alvaroferran/ZOOK/3D/Images/zookRender.jpg

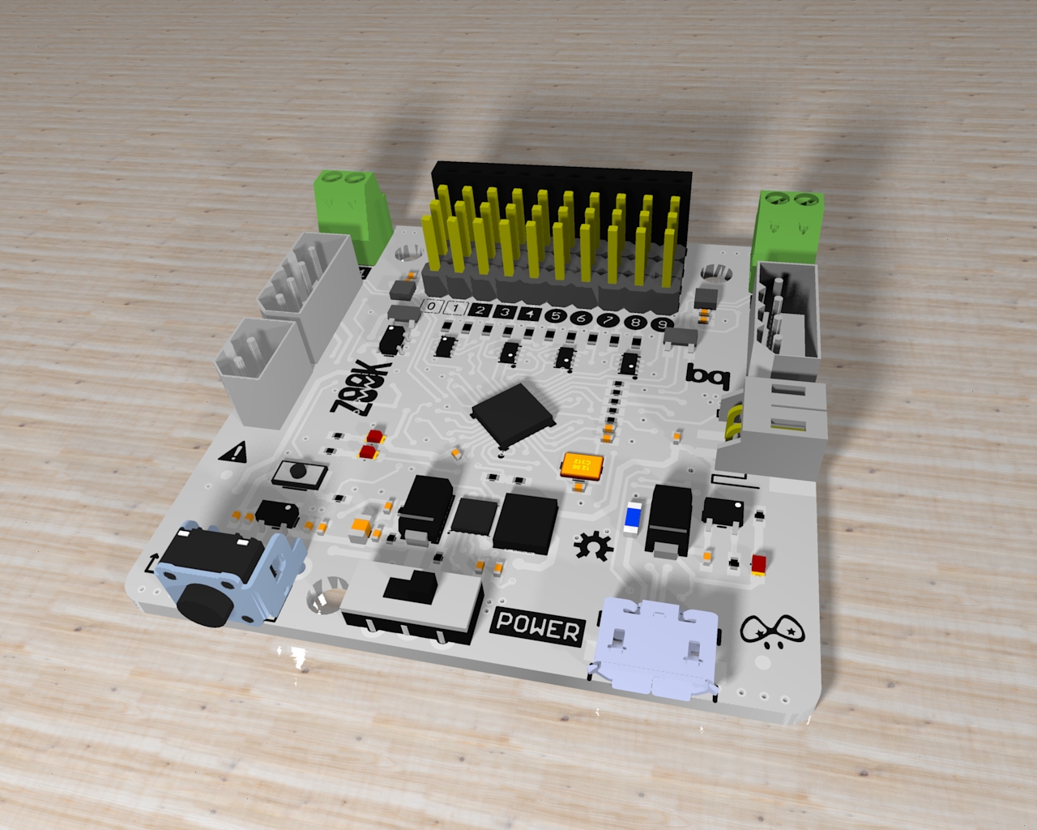
3D/Images/zookRender.jpg
