alvaroferran/ZOOK/Pres/zook_render.png

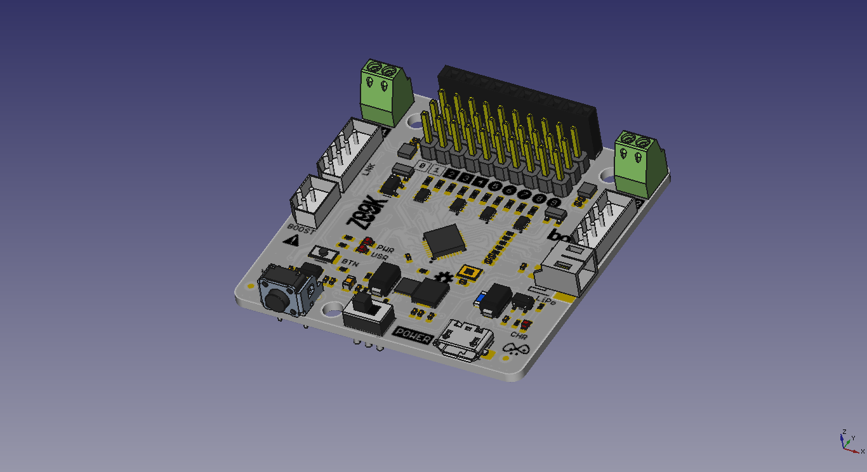
Pres/zook_render.png
