alvaroferran/ZOOK/3D/Images/zook1.png

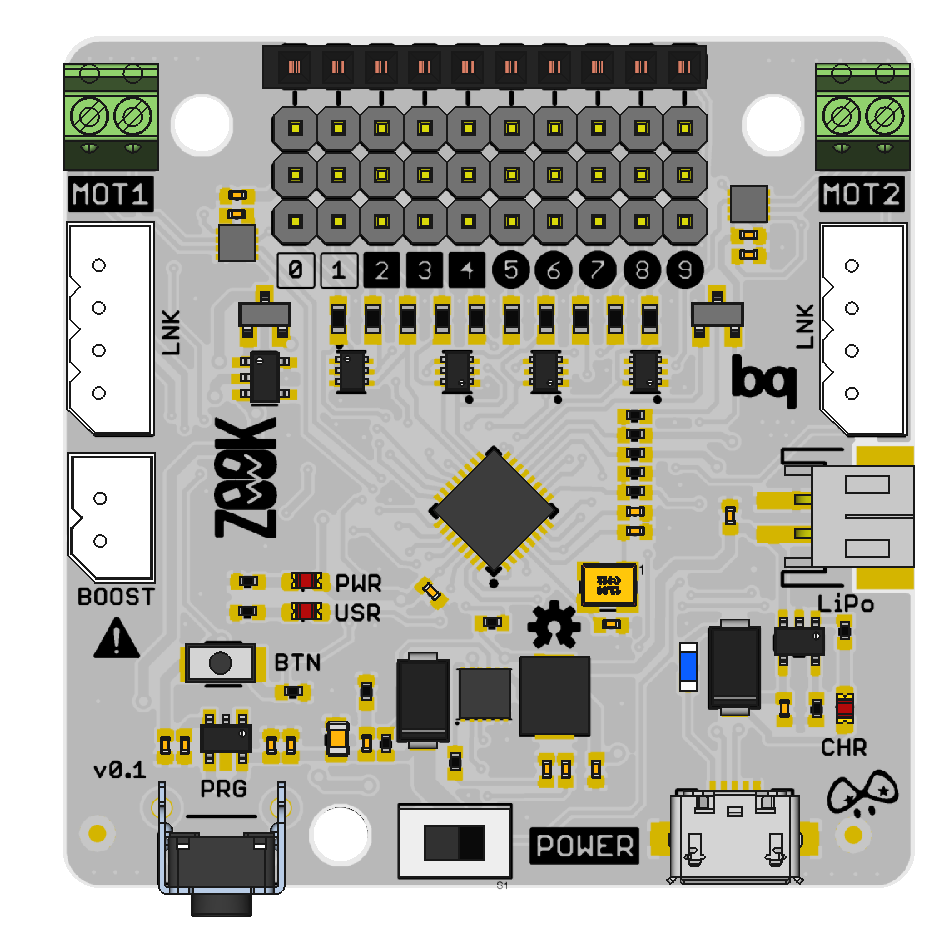
3D/Images/zook1.png
