alvaroferran/ZOOK/3D/Images/zook2.png

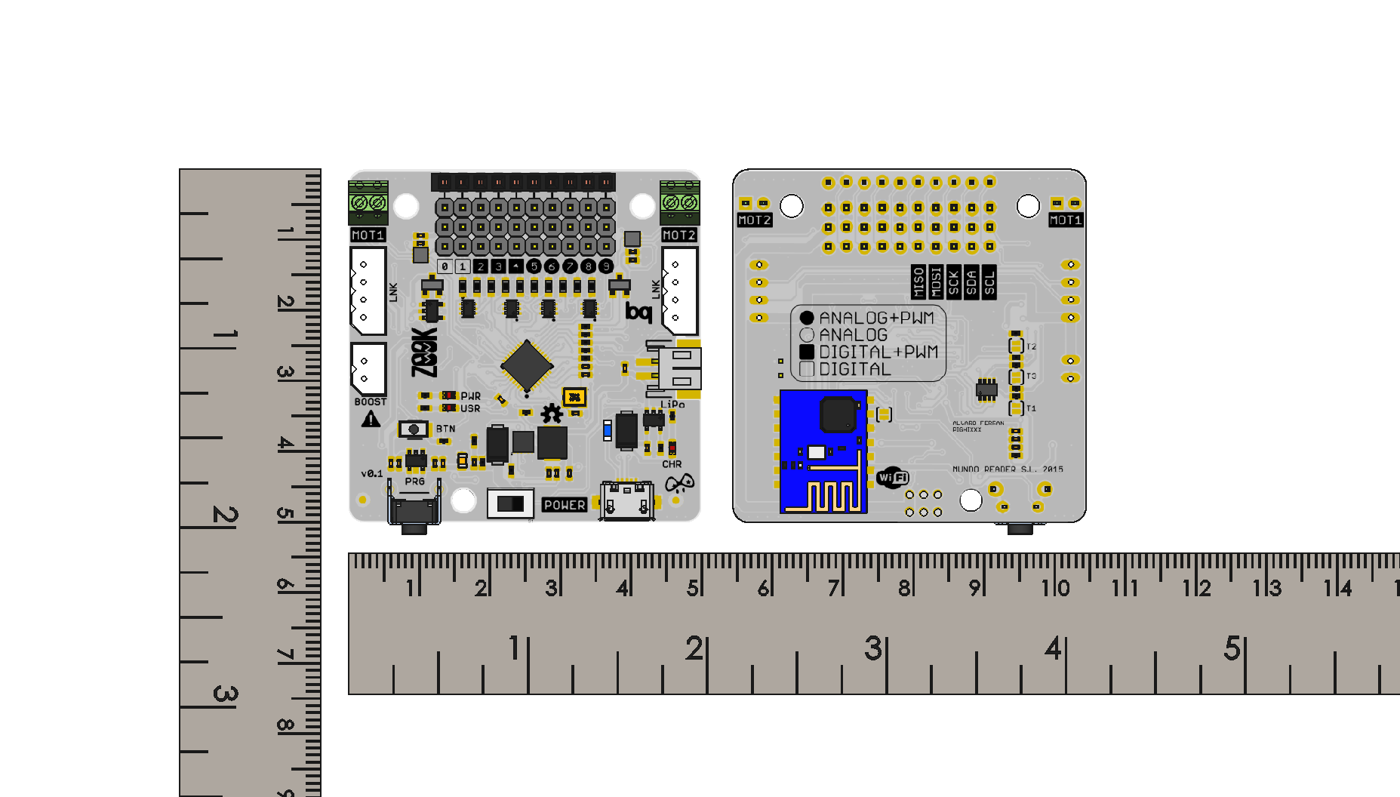
3D/Images/zook2.png
