alvaroferran/ZOOK/eagleUp/back.png

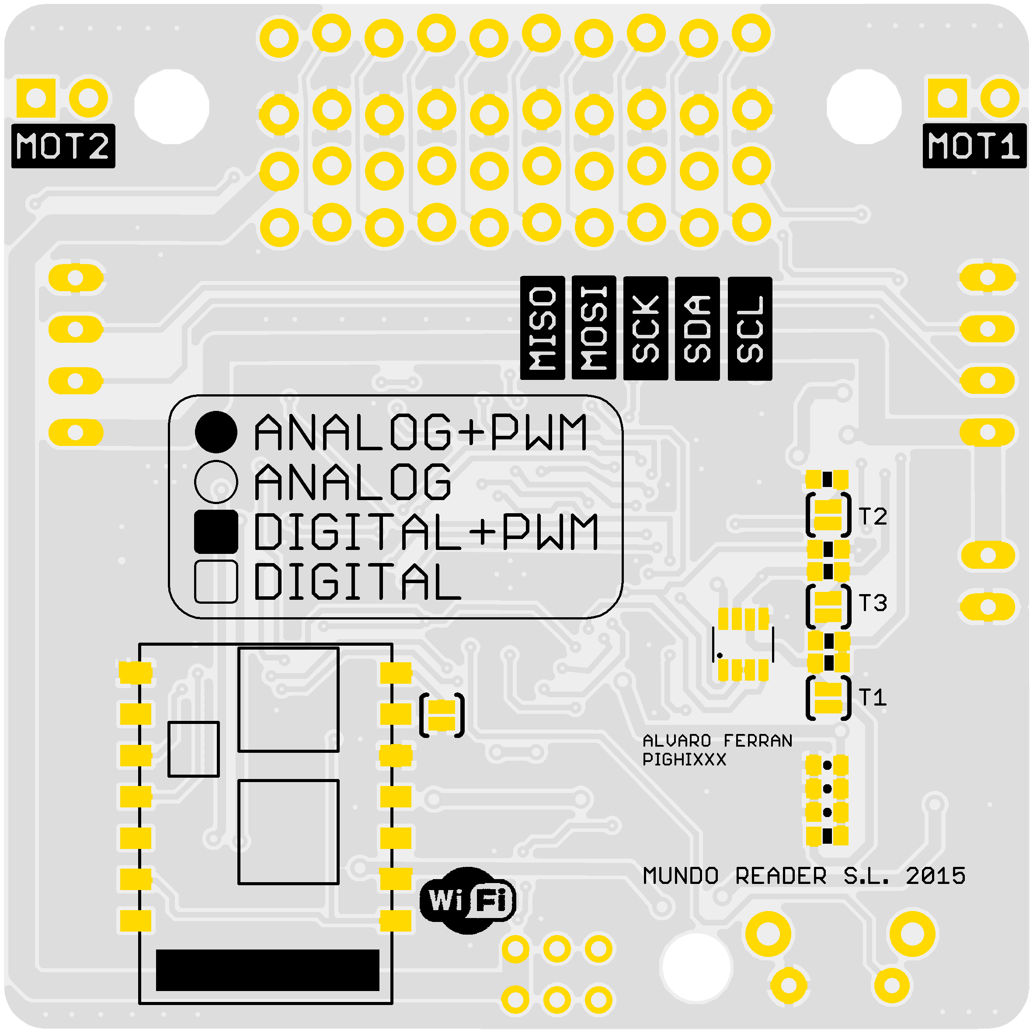
eagleUp/back.png
