alvaroferran/ZOOK/eagleUp/eagleUp_zook_board_top.png

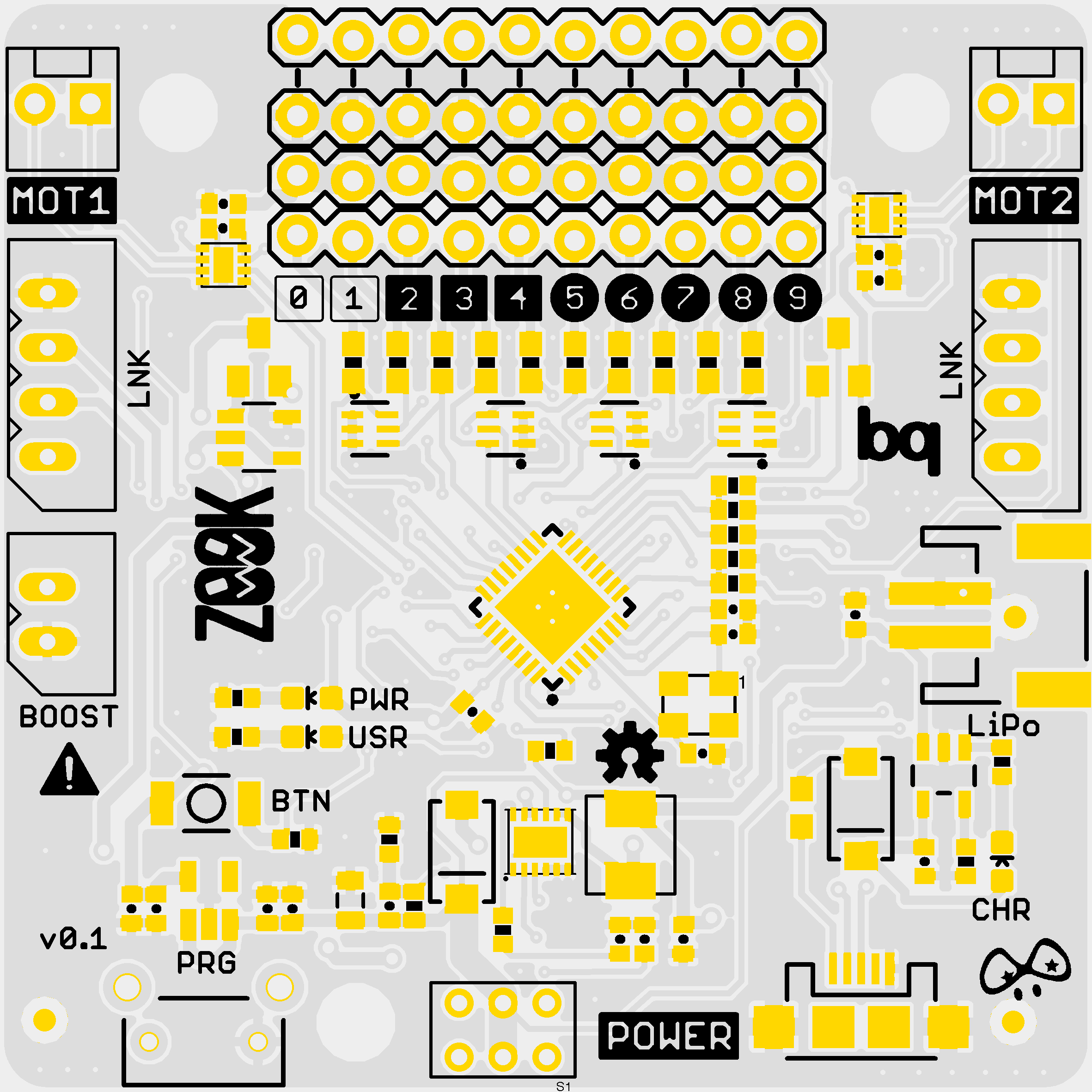
eagleUp/eagleUp_zook_board_top.png
