alvaroferran/ZOOK/eagleUp/eagleUp_zook_bottom.png

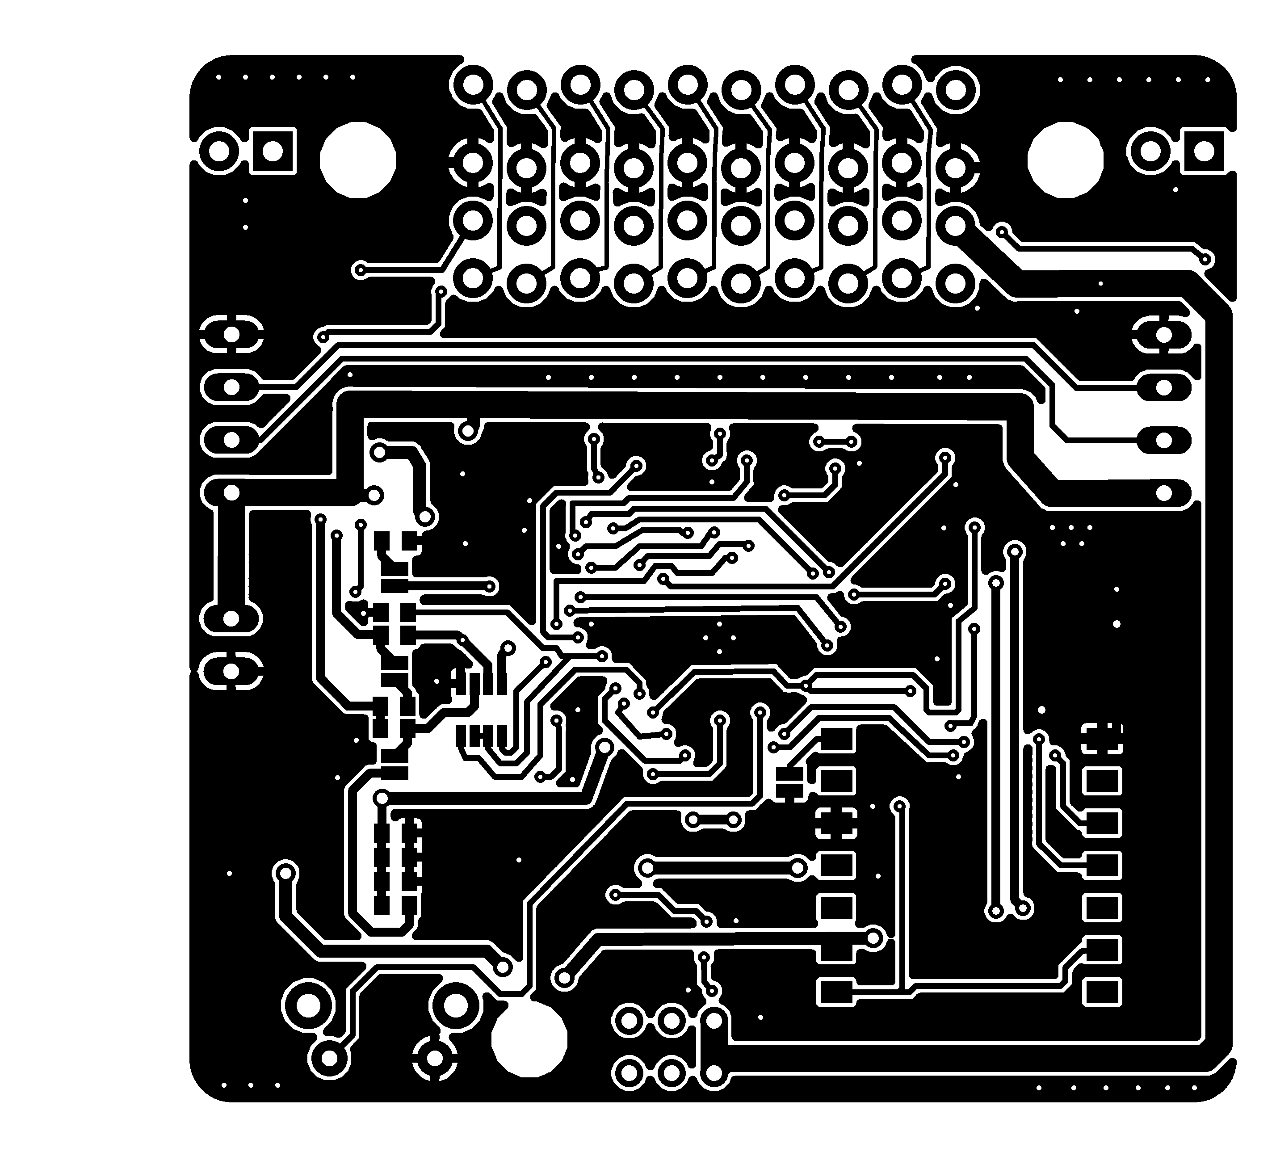
eagleUp/eagleUp_zook_bottom.png
