alvaroferran/ZOOK/eagleUp/eagleUp_zook_bottom_mask.png

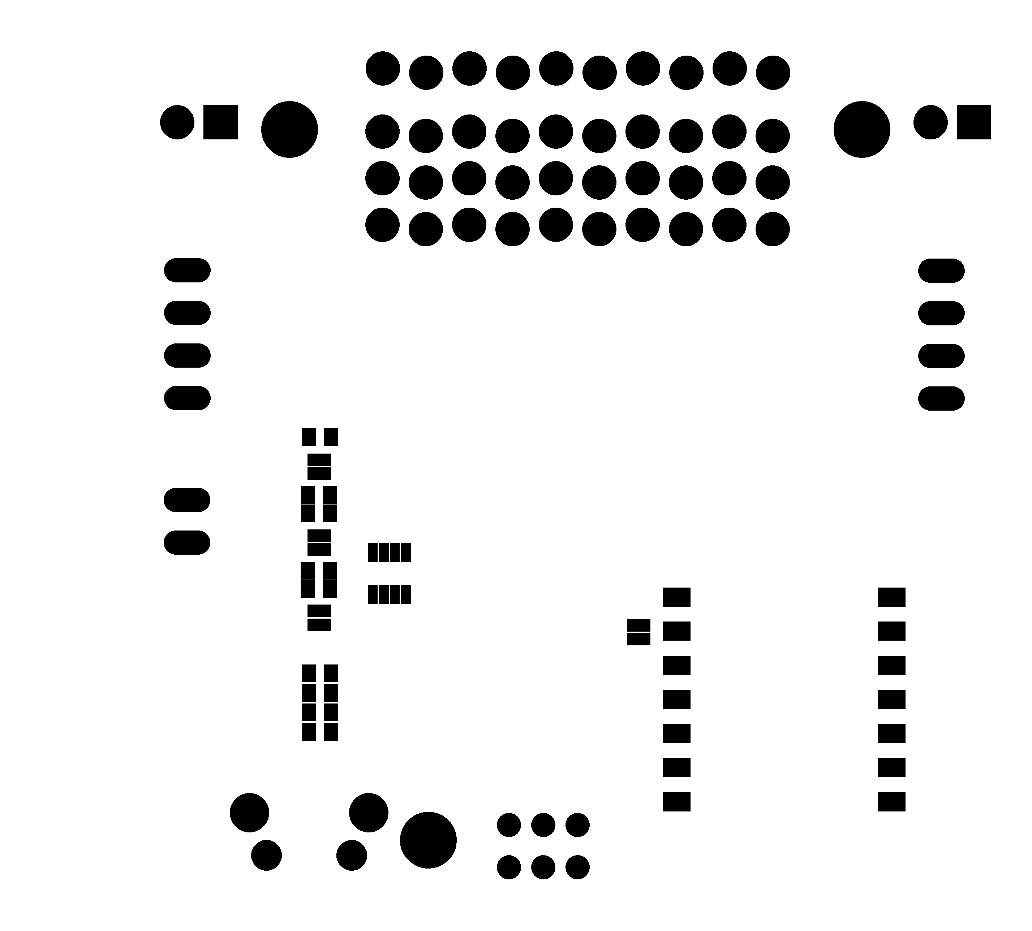
eagleUp/eagleUp_zook_bottom_mask.png
