alvaroferran/ZOOK/eagleUp/eagleUp_zook_bottom_silk.png

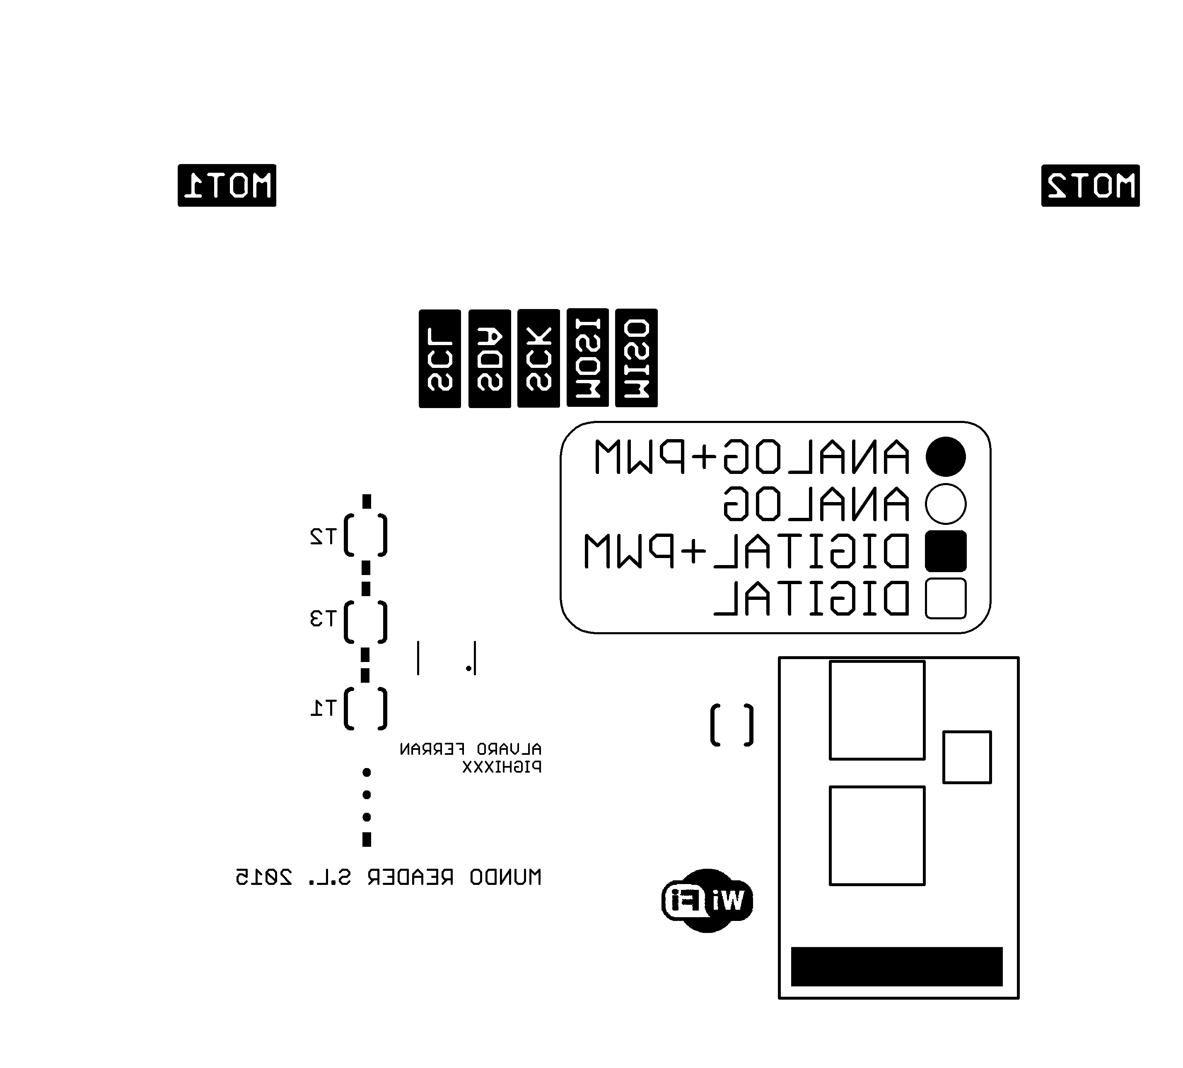
eagleUp/eagleUp_zook_bottom_silk.png
