alvaroferran/ZOOK/eagleUp/eagleUp_zook_imagesize.png

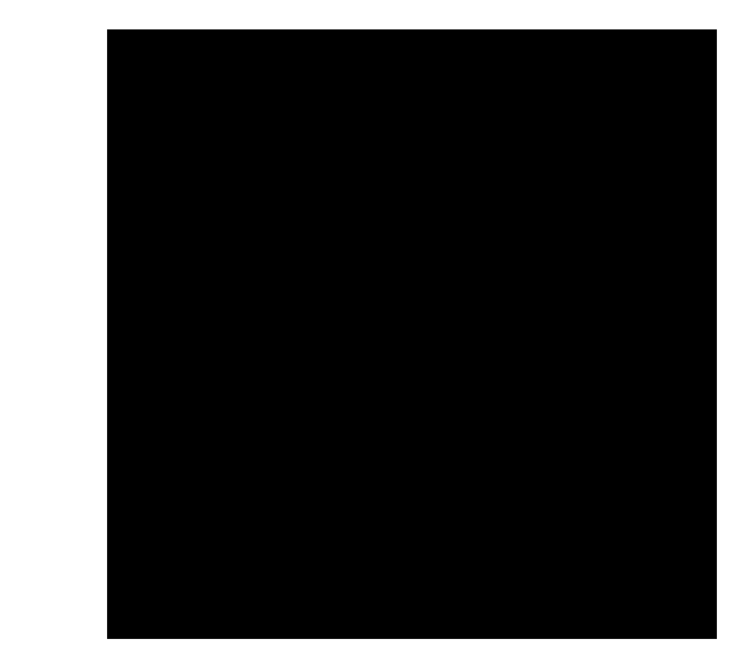
eagleUp/eagleUp_zook_imagesize.png
