alvaroferran/ZOOK/eagleUp/eagleUp_zook_outline.png

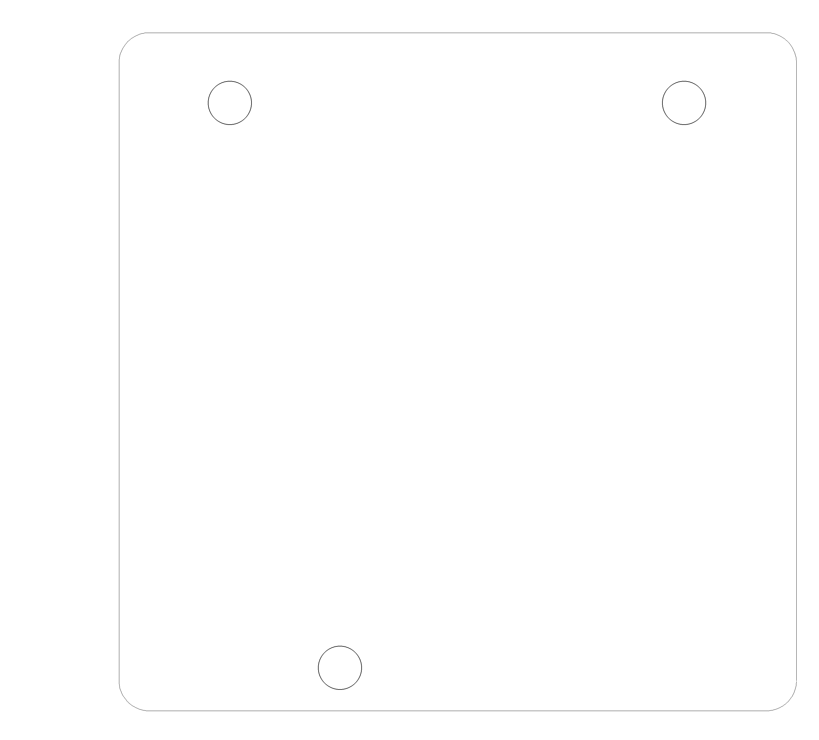
eagleUp/eagleUp_zook_outline.png
