alvaroferran/ZOOK/eagleUp/eagleUp_zook_top.png

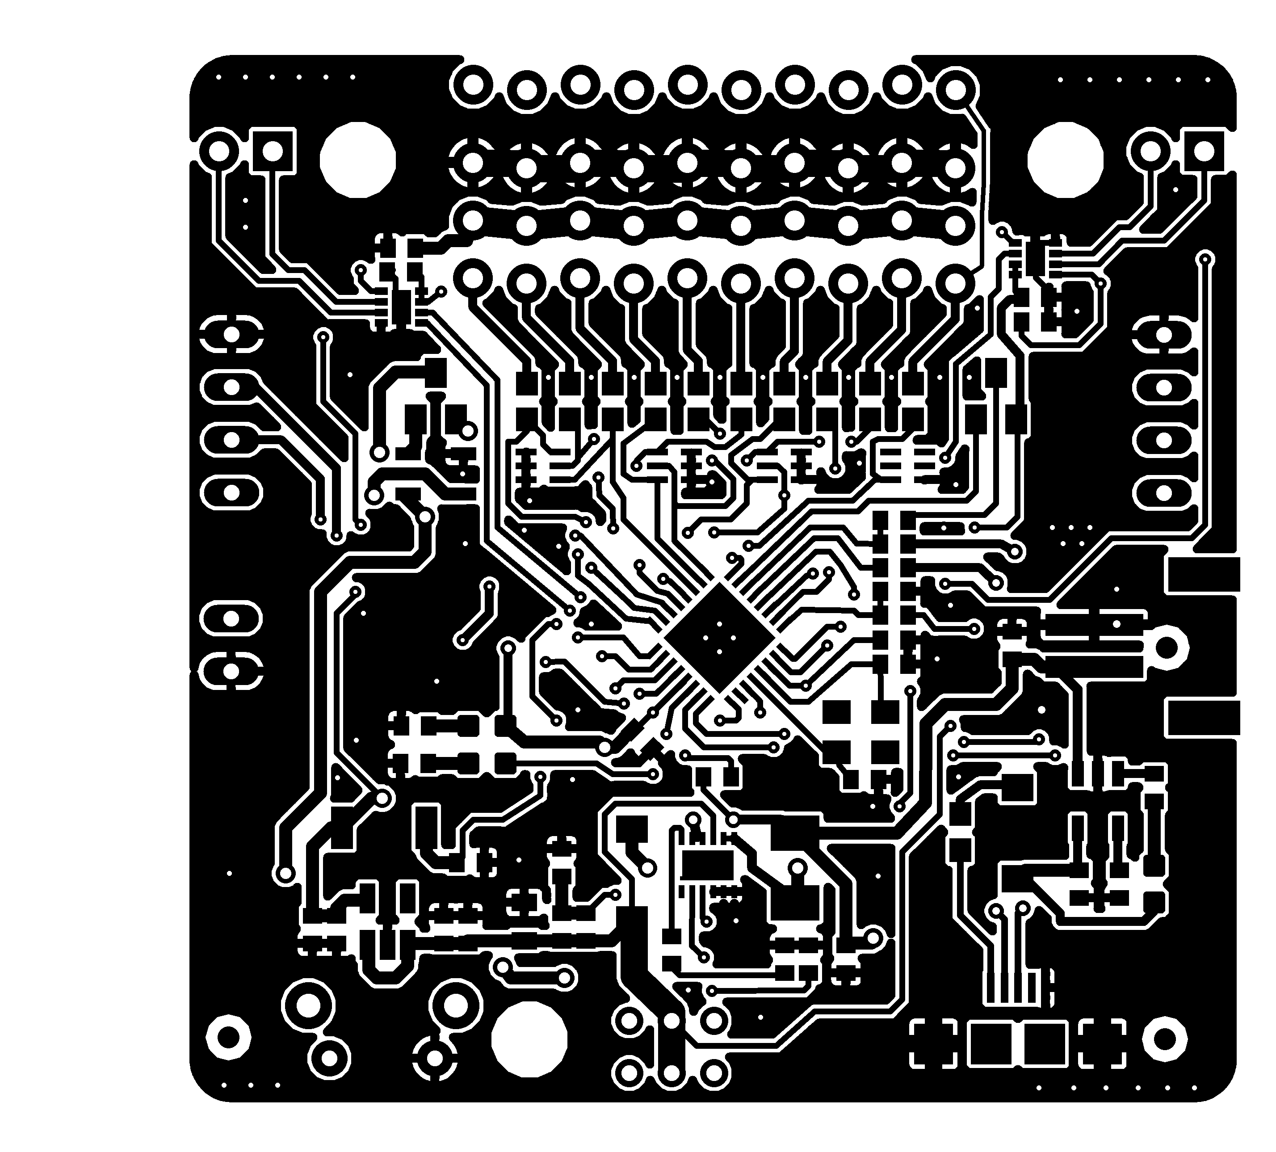
eagleUp/eagleUp_zook_top.png
