alvaroferran/ZOOK/eagleUp/eagleUp_zook_top_mask.png

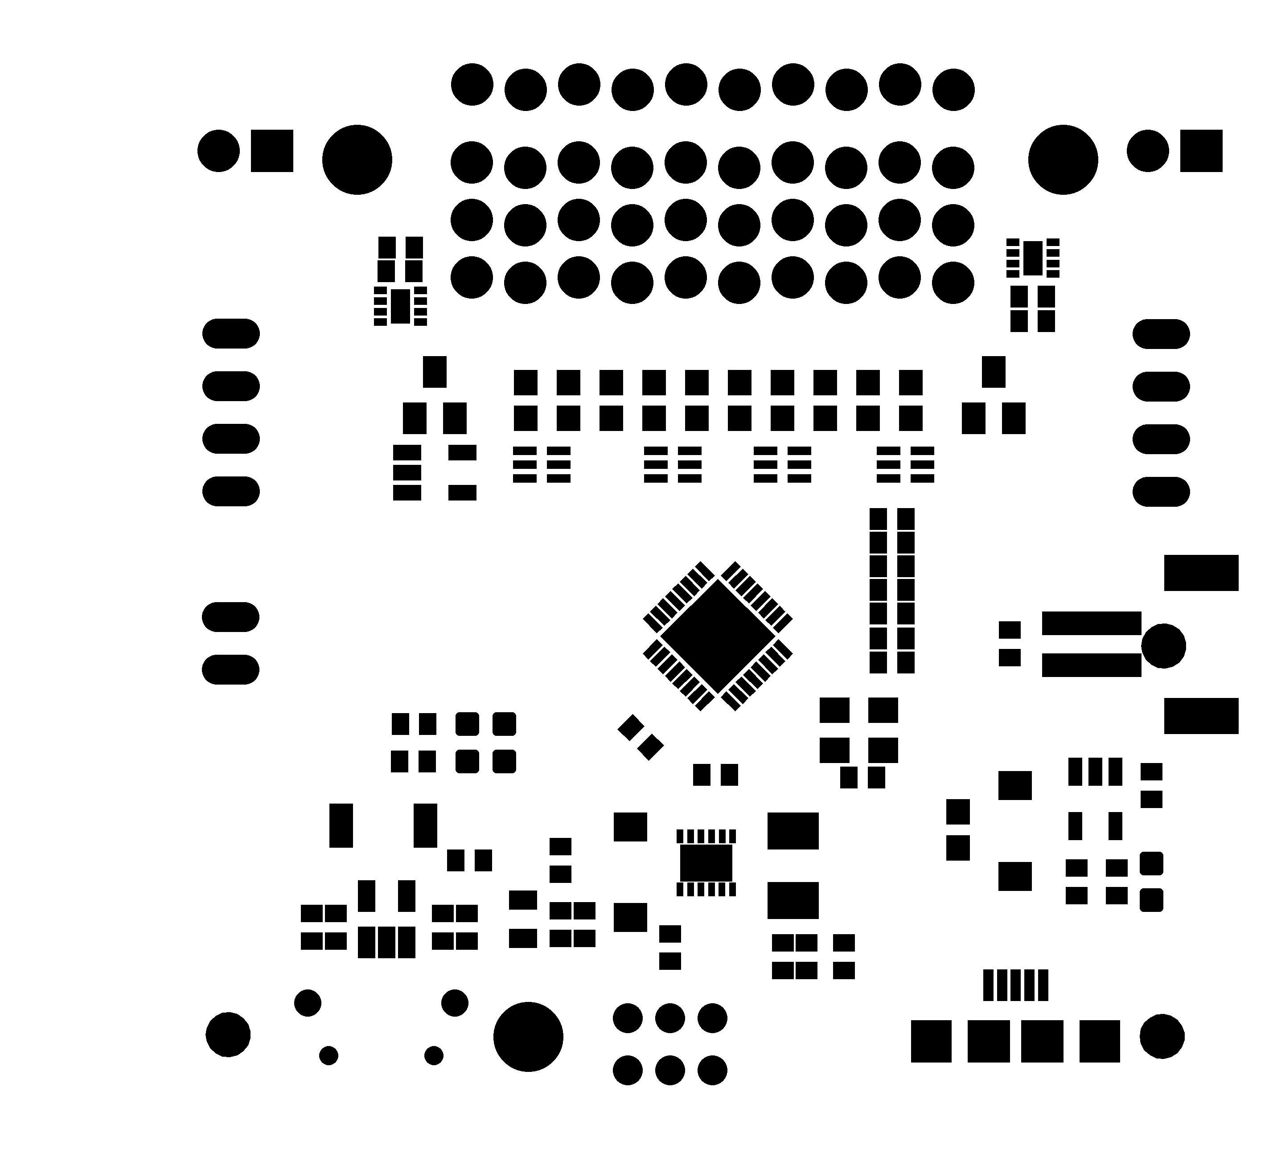
eagleUp/eagleUp_zook_top_mask.png
