alvaroferran/ZOOK/eagleUp/eagleUp_zook_top_silk.png

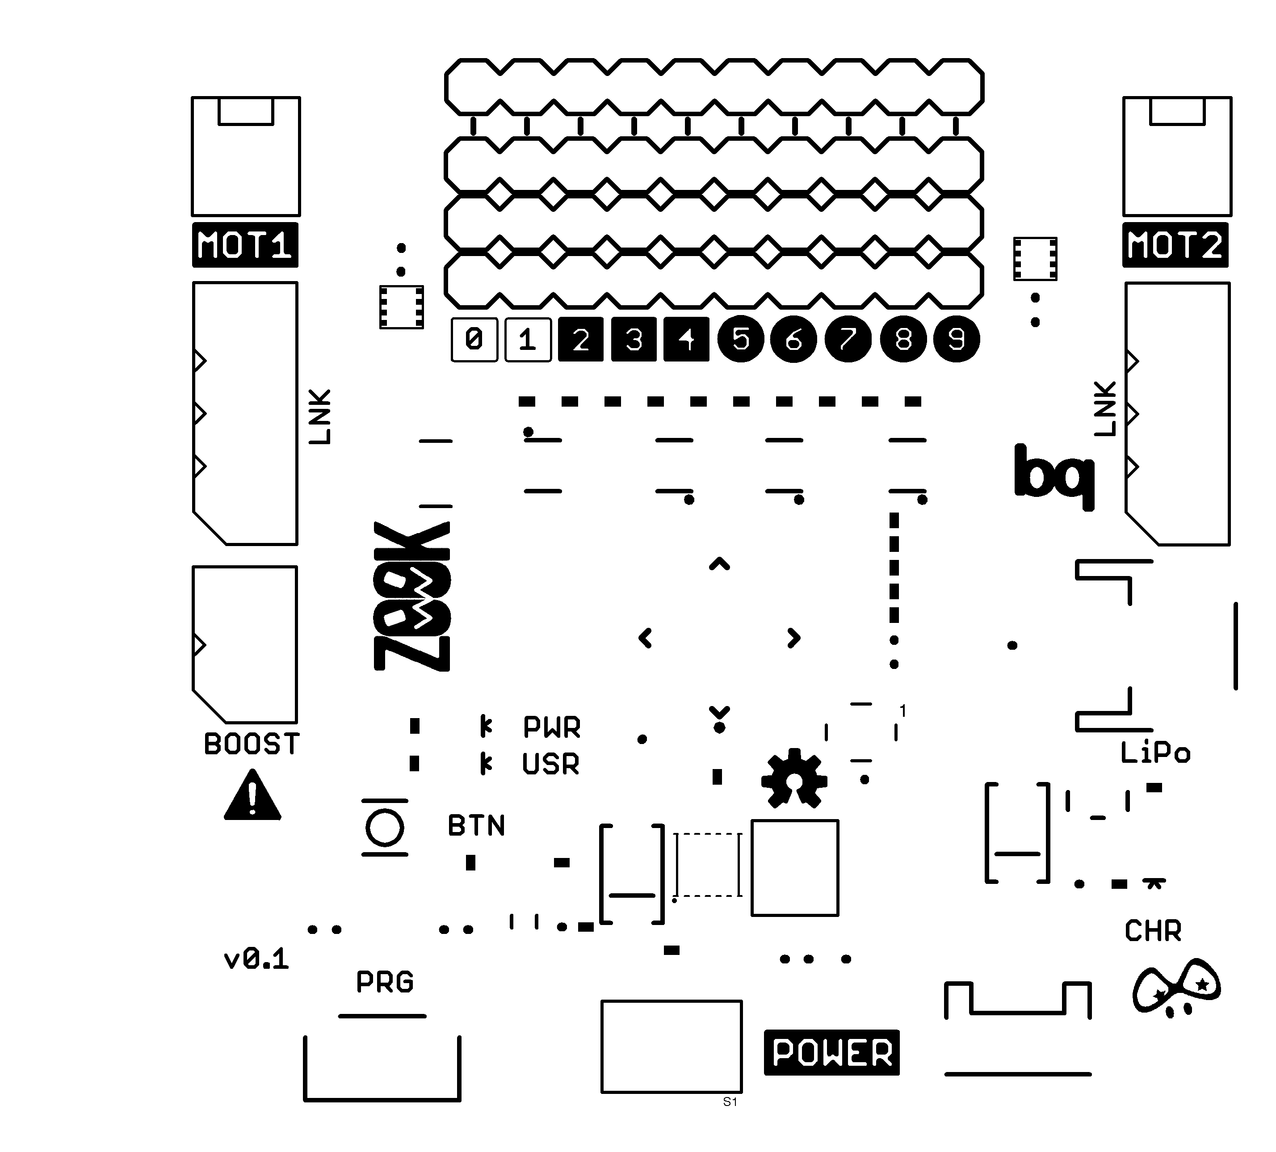
eagleUp/eagleUp_zook_top_silk.png
