alvaroferran/ZOOK/BOM/bom.ods

Part | Value | Device | Package | Description | Vendor | Code | Price | Notes
C1 | 0.1uF | CAP0402-CAP | 0402-CAP | Capacitor | TME | 0402YD104KAT2A | 0.00247
C2 | 0.1uF | CAP0402-CAP | 0402-CAP | Capacitor | TME | 0402YD104KAT2A | 0.00247
C3 | 2.2uF | CAP0402-CAP | 0402-CAP | Capacitor | TME | CL05A225KP5NSNC | 0.03218
C4 | 4.7uF | CAP0402-CAP | 0402-CAP | Capacitor | TME | AMK105BJ475MV | 0.1014
C5 | 10nF | CAP0402-CAP | 0402-CAP | Capacitor | TME | 0402YC103KAT2A | 0.0022
C6 | 100pF | CAP0402-CAP | 0402-CAP | Capacitor | TME | CL05C101JB5NNNC | 0.002
C7 | 22uF | CAP0805-CAP | 0805-CAP | Capacitor | TME | CL21A226MQQNNNG | 0.01476
C8 | 0.1uF | CAP0402-CAP | 0402-CAP | Capacitor | TME | 0402YD104KAT2A | 0.00247
C9 | 1uF | CAP0402-CAP | 0402-CAP | Capacitor | TME | CL05A105KQ5NNNC | 0.00297
C10 | 10uF 10V | CAP0402-CAP | 0402-CAP | Capacitor | TME | CL05A106MQ5NUNC | 0.0297
C11 | 10uF 10V | CAP0402-CAP | 0402-CAP | Capacitor | TME | CL05A106MQ5NUNC | 0.0297
C12 | 4.7uF | CAP0402-CAP | 0402-CAP | Capacitor | TME | AMK105BJ475MV | 0.1014
C13 | 10uF 10V | CAP0402-CAP | 0402-CAP | Capacitor | TME | CL05A106MQ5NUNC | 0.0297
C14 | 0.1uF | CAP0402-CAP | 0402-CAP | Capacitor | TME | 0402YD104KAT2A | 0.00247
C15 | 1uF | CAP0402-CAP | 0402-CAP | Capacitor | TME | CL05A105KQ5NNNC | 0.00297
C16 | 0.1uF | CAP0402-CAP | 0402-CAP | Capacitor | TME | 0402YD104KAT2A | 0.00247
C17 | 27pF | CAP0402-CAP | 0402-CAP | Capacitor | TME | CL05C270JB5NNNC | 0.00249
C18 | 27pF | CAP0402-CAP | 0402-CAP | Capacitor | TME | CL05C270JB5NNNC | 0.00249
C19 | 0.1uF | CAP0402-CAP | 0402-CAP | Capacitor | TME | 0402YD104KAT2A | 0.00247
C20 | 0.1uF | CAP0402-CAP | 0402-CAP | Capacitor | TME | 0402YD104KAT2A | 0.00247
C21 | 0.1uF | CAP0402-CAP | 0402-CAP | Capacitor | TME | 0402YD104KAT2A | 0.00247
C22 | 0.1uF | CAP0402-CAP | 0402-CAP | Capacitor | TME | 0402YD104KAT2A | 0.00247
D1 | MBRA140 | MBRA140 | SMA-DIODE | 40V, 1A Schottky rectifier | DIGIKEY | MBRA140T3GOSCT-ND | 0,098827
D2 | ZENERARRAY | ZENERARRAY | SOT363 |  | DIGIKEY | BZX84C5V1TS-FDICT-ND | 0,098827
D3 | ZENERARRAY | ZENERARRAY | SOT363 |  | DIGIKEY | BZX84C5V1TS-FDICT-ND | 0,098827
D4 | ZENERARRAY | ZENERARRAY | SOT363 |  | DIGIKEY | BZX84C5V1TS-FDICT-ND | 0,098827
D5 | ZENERARRAY | ZENERARRAY | SOT363 |  | DIGIKEY | BZX84C5V1TS-FDICT-ND | 0,098827
D6 | B340A | DIODE-SCHOTTKY-B340A | SMA-DIODE | Schottky diodes in SFEs production catalog | TME | B340A-13-F | 0.1182
F1 | PTC0603 | PTC0603 | 603 | Resettable Fuse PTC | AE |  | 0.2
IC1 | LMC7101AIM5 | LMC7101AIM5 | SOT23-5 |  | TME | LMC7101AIM5NOPB | 0.47
J1 | 5267-4 | 5267-4 | 5267-4 |  | TME | MX-5267-04A | 0.0524
J2 | 5267-4 | 5267-4 | 5267-4 |  | TME | MX-5267-04A | 0.0524
J3 | BATT | JST_2MM_MALE | JST-2-SMD | Mates to single-cell LiPo batteries. | DIGIKEY | 455-1704-ND | 0,066266
J5 | 5267-2 | 5267-2 | 5267-2 |  | TME | MX-5267-02A | 0.0302
JP1 | M10LOCK | M10LOCK | 1X10_LOCK | Header 10 | TME | ZL201-10G | 0.04504
JP2 | USB-MICROB | USB-MICROB | USB-MICROB | USB Connectors | ED |  | 0.11
JP3 | M10LOCK | M10LOCK | 1X10_LOCK | Header 10 | TME | ZL201-10G | 0.04504
JP4 | M10LOCK | M10LOCK | 1X10_LOCK | Header 10 | TME | ZL201-10G | 0.04504
JP5 | MOT1 | M02POLAR | MOLEX-1X2 | Standard 2-pin 0.1" header. Use with | TME | 282834-2 | 0.39
JP6 | MOT2 | M02POLAR | MOLEX-1X2 | Standard 2-pin 0.1" header. Use with | TME | 282834-2 | 0.39
L1 | MPI4040R3-2R2-R | MPI4040R3-2R2-R | MPI4040R3-2R2-R |  | Farnell | 2145278 | 0.536
LED1 |  | LED0603 | LED-0603 | LEDs | TME | OSR50603C1C | 0.0201
LED2 |  | LED0603 | LED-0603 | LEDs | TME | OSR50603C1C | 0.0201
LED3 |  | LED0603 | LED-0603 | LEDs | TME | OSR50603C1C | 0.0201
Q1 | 12MHz 4 pad crystal 3.2x2.5 | CRYSTAL3.2X2.5 | CRYSTAL_3.2X2.5 |  | Vertical | ABM8-12.000MHZ-B2-T | 0.28
Q2 | BSS84 | BSS84 | SOT23 | P-CHANNEL MOS FET | TME | BSS84.215 | 0.0289
Q3 | IRLML9301TR | BSS84 | SOT23 | P-CHANNEL MOS FET | TME | IRLML9301TRPBF | 0.0651
R1 | 100k | RESISTOR0402-RES | 0402-RES | Resistor | TME | SMD0402-100K | 0.00237
R2 | 220 | RESISTOR0603-RES | 0603-RES | Resistor | TME | SMD0603-220R-1% | 0.0022
R3 | 220 | RESISTOR0603-RES | 0603-RES | Resistor | TME | SMD0603-220R-1% | 0.0022
R4 | 220 | RESISTOR0603-RES | 0603-RES | Resistor | TME | SMD0603-220R-1% | 0.0022
R5 | 220 | RESISTOR0603-RES | 0603-RES | Resistor | TME | SMD0603-220R-1% | 0.0022
R6 | 220 | RESISTOR0603-RES | 0603-RES | Resistor | TME | SMD0603-220R-1% | 0.0022
R7 | 220 | RESISTOR0603-RES | 0603-RES | Resistor | TME | SMD0603-220R-1% | 0.0022
R8 | 220 | RESISTOR0603-RES | 0603-RES | Resistor | TME | SMD0603-220R-1% | 0.0022
R9 | 220 | RESISTOR0603-RES | 0603-RES | Resistor | TME | SMD0603-220R-1% | 0.0022
R10 | 220 | RESISTOR0603-RES | 0603-RES | Resistor | TME | SMD0603-220R-1% | 0.0022
R11 | 220 | RESISTOR0603-RES | 0603-RES | Resistor | TME | SMD0603-220R-1% | 0.0022
R12 | 620 | RESISTOR0402-RES | 0402-RES | Resistor | TME | SMD0402-620R-1% | 0.00237
R13 | 4.7k | RESISTOR0402-RES | 0402-RES | Resistor | TME | SMD0402-4K7-1% | 0.00237
R14 | 4.7k | RESISTOR0402-RES | 0402-RES | Resistor | TME | SMD0402-4K7-1% | 0.00237
R15 | 30.9k | RESISTOR0402-RES | 0402-RES | Resistor | DIGIKEY | 541-30.9KLCT-ND | 0,016693
R16 | 56 | RESISTOR0402-RES | 0402-RES | Resistor | TME | SMD0402-56R-1% | 0.00237
R17 | 56 | RESISTOR0402-RES | 0402-RES | Resistor | TME | SMD0402-56R-1% | 0.00237
R18 | 10k | RESISTOR0402-RES | 0402-RES | Resistor | TME | RC0402FR-0710K | 0.002
R19 | 330 | RESISTOR0402-RES | 0402-RES | Resistor | TME | SMD0402-330R-1% | 0.00237
R20 | 120 | RESISTOR0402-RES | 0402-RES | Resistor | TME | SMD0402-120R-1% | 0.00237
R21 | 330 | RESISTOR0402-RES | 0402-RES | Resistor | TME | SMD0402-330R-1% | 0.00237
R22 | 10k | RESISTOR0402-RES | 0402-RES | Resistor | TME | RC0402FR-0710K | 0.002
R23 | 330 | RESISTOR0402-RES | 0402-RES | Resistor | TME | SMD0402-330R-1% | 0.00237
R24 | 2K | RESISTOR0402-RES | 0402-RES | Resistor | TME | SMD0402-2K-1% | 0.00237
R25 | 1k | RESISTOR0402-RES | 0402-RES | Resistor | TME | SMD0402-1K-1% | 0.00237
R26 | 100k | RESISTOR0402-RES | 0402-RES | Resistor | TME | SMD0402-100K | 0.00237
R27 | 1.5K | RESISTOR0402-RES | 0402-RES | Resistor | TME | SMD0402-1K5-1% | 0.00237
R28 | 33 | RESISTOR0402-RES | 0402-RES | Resistor | TME | SMD0402-33R-1% | 0.00237
R29 | 33 | RESISTOR0402-RES | 0402-RES | Resistor | TME | SMD0402-33R-1% | 0.00237
R30 | 0 | RESISTOR0402-RES | 0402-RES | Resistor | TME | SMD0402-0R | 0.00237
S1 |  | SWITCH-MOMENTARY-2SMD-3 | TACTILE_SWITCH_SMD-3 | Various NO switches- pushbuttons, reed, etc | ED | EVP-AKB11A | 0.04
S2 |  | SWITCH-SPDTPTH | SWITCH-SPDT | SPDT Switch | ED | 563-1387-ND | 0.06 | 563-1385-ND | 1.62885
S3 | PROGR | SWITCH-MOMENTARY-2SIDE_EZ | TACTILE-PTH-SIDEEZ | Various NO switches- pushbuttons, reed, etc | DIGIKEY | 450-1662-ND | 0,091151
U1 |  | MIC2253 | MLF12_3.0MM_X_3.0MM | MIC2253 – 3.5ABoost Regulator | DIGIKEY | 576-3643-1-ND | 0,957827
U2 | ESP8266 | ESP8266 | ESP-03 | low cost Wifi to Serial Module | ED |  | 1
U3 | MCP73831 | MCP73831 | SOT23-5 | Miniature single cell Li-polymer charge controller | TME | MCP73831T-2AT | 0.45
U4 | DRV8837 | DRV8837 | DSG |  | DIGIKEY | 296-34786-2-ND | 0.506
U5 | DRV8837 | DRV8837 | DSG |  | DIGIKEY | 296-34786-2-ND | 0.506
U6 | AP2112K-3.3TRG1 3.3V | 5PIN_REG | SOT23-5 |  | DIGIKEY | AP2112K-3.3TRG1DICT-ND | 0,11076
U8 | LPC11U24 | LPC11U2X_HVQFN33(5X5) | HVQFN33_5X5MM |  | NEWARK | 74T4533 | 1.4
U9 | MAX3362 | MAX3362 | SOT23-8 | MAX3362 3.3VRS-485/RS-422 Transceiver | MAXIM | MAX3362AKA (https://shop.maximintegrated.com/storefront/quotecart.do;jsessionid=0181a53e4de57686ba28963c263dcfc0181b3e8e9cc94afbef82d4042b7d6509.e38Mbx8MbNuPaO0PahiMb3eOb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) | 1.5
 |  |  |  |  |  |  | 10.539832
