alvaroferran/ZOOK/BOM/bom.numbers/preview-web.jpg

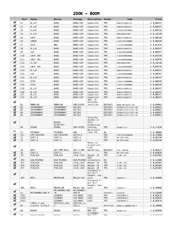
BOM/bom.numbers/preview-web.jpg
