alvaroferran/ZOOK/Outline/Outline.dxf

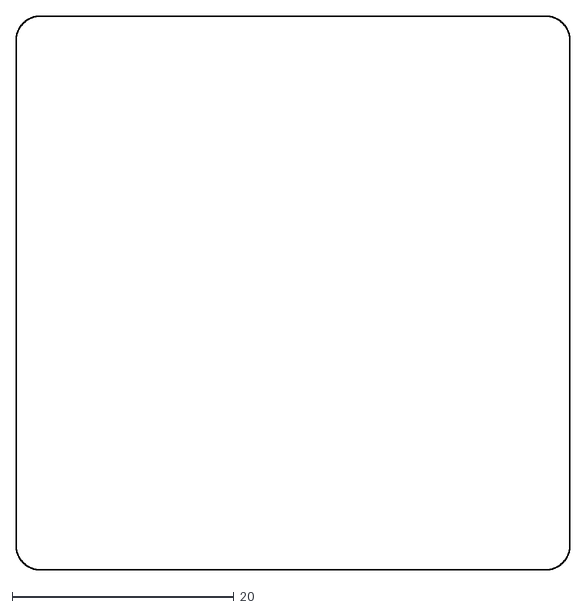
[picture p17: CAD file, 2015-11-03]
Outline/Outline.dxf
50.0 x 50.0
