alvaroferran/ZOOK/Pres/zook_freecad.fcstd

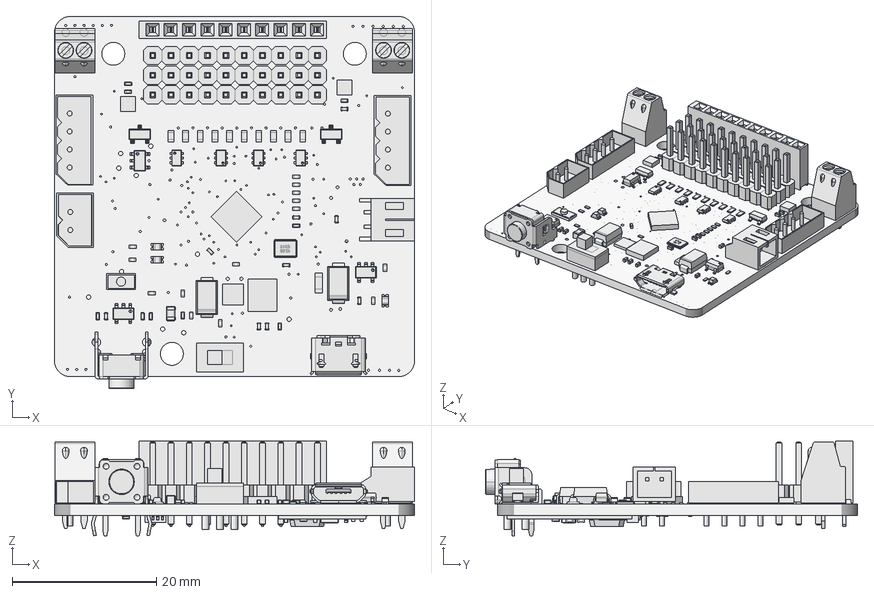
[picture p18: CAD file, 2015-11-03]
Pres/zook_freecad.fcstd
50.0 x 51.6 x 13.1 mm
Board
Q3
Q1
R18
R12
R15
R24
R19
R13
R14
R16
R17
R20
R1
R25
R26
R29
R28
R27
R21
R23
R22
R30
C4
C12
C9
C15
C3
C1
C6
C5
C11
C13
C19
C21
C20
C22
C2
C10
C8
C17
C18
C14
C16
U2
D6
D1
U5
IC1
U4
JP2
J4
C7
U6
U7
JP5
JP6
LED1
LED2
LED3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
