alvaroferran/ZOOK/Pres/zook_schematic.pdf

1

2

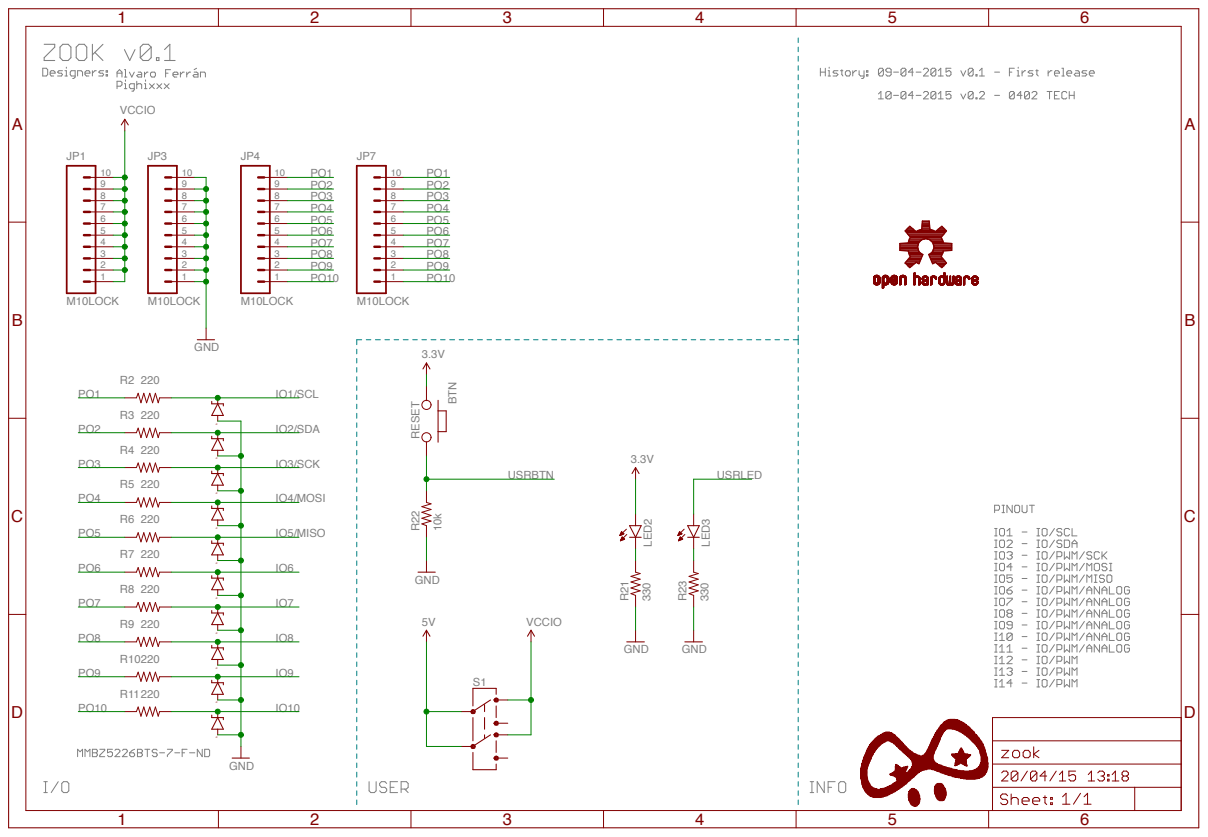
[picture p19: page 1]

1 | 2 | 3 | 4 | 5 | 6

A

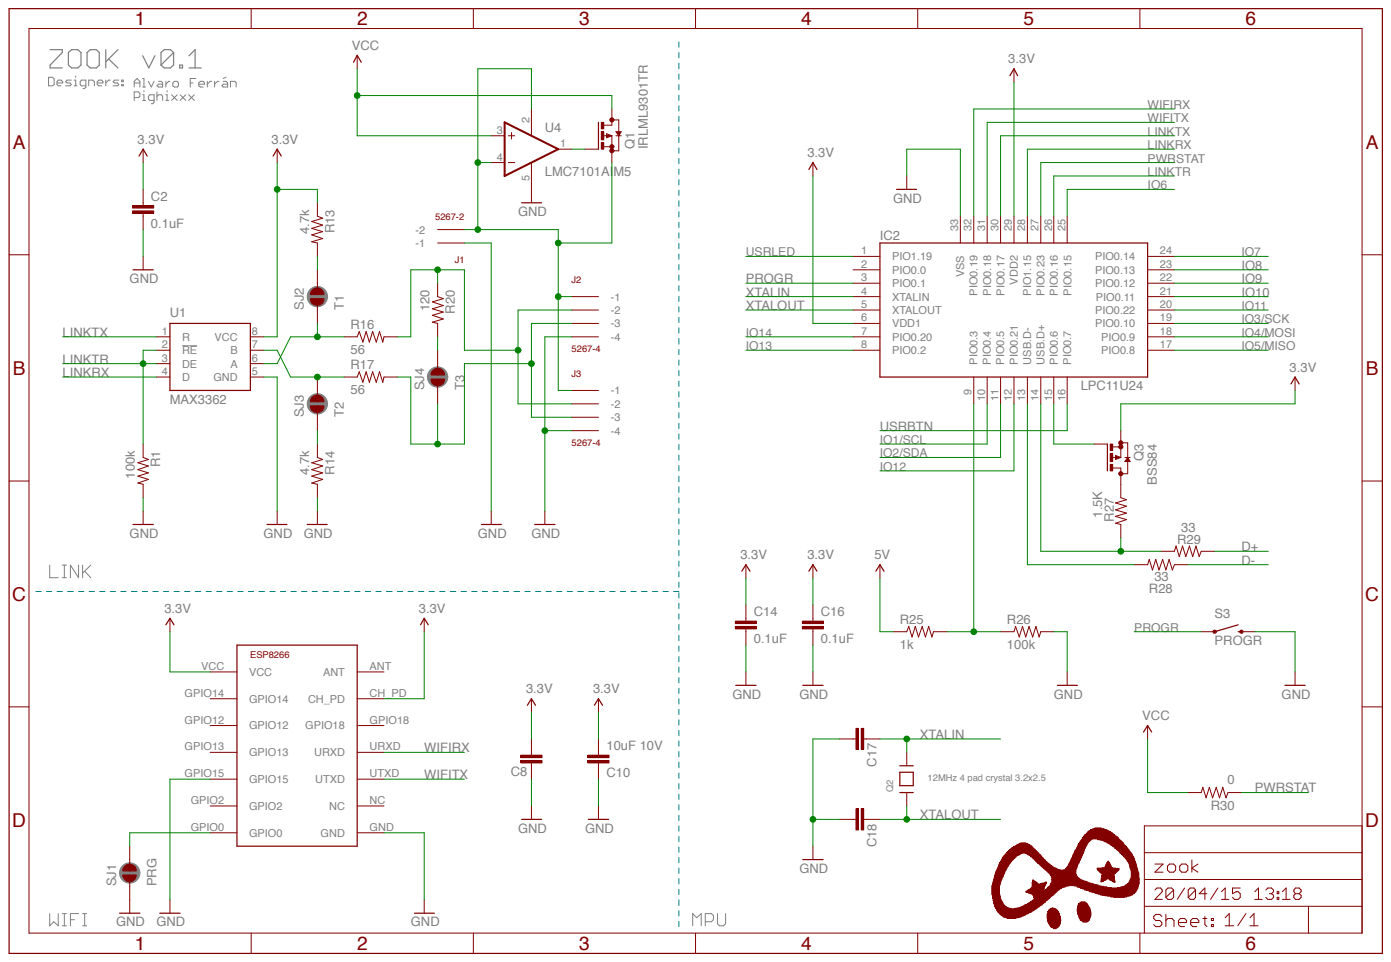
[picture p20: page 2]

VCC

A

A

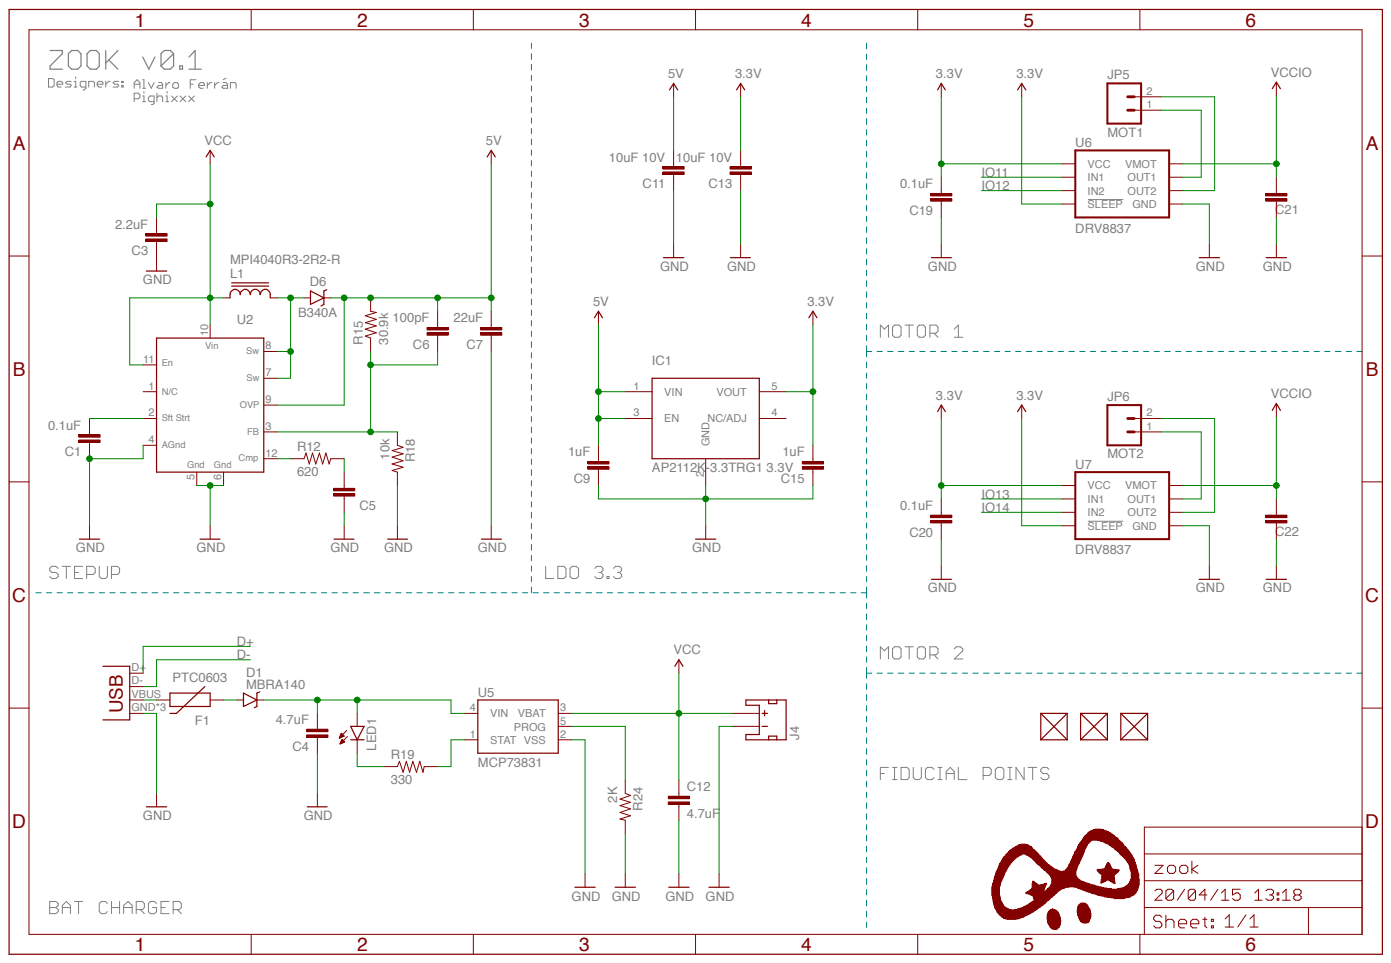
[picture p21: page 3]
