alvaroferran/ZOOK/zook.pdf

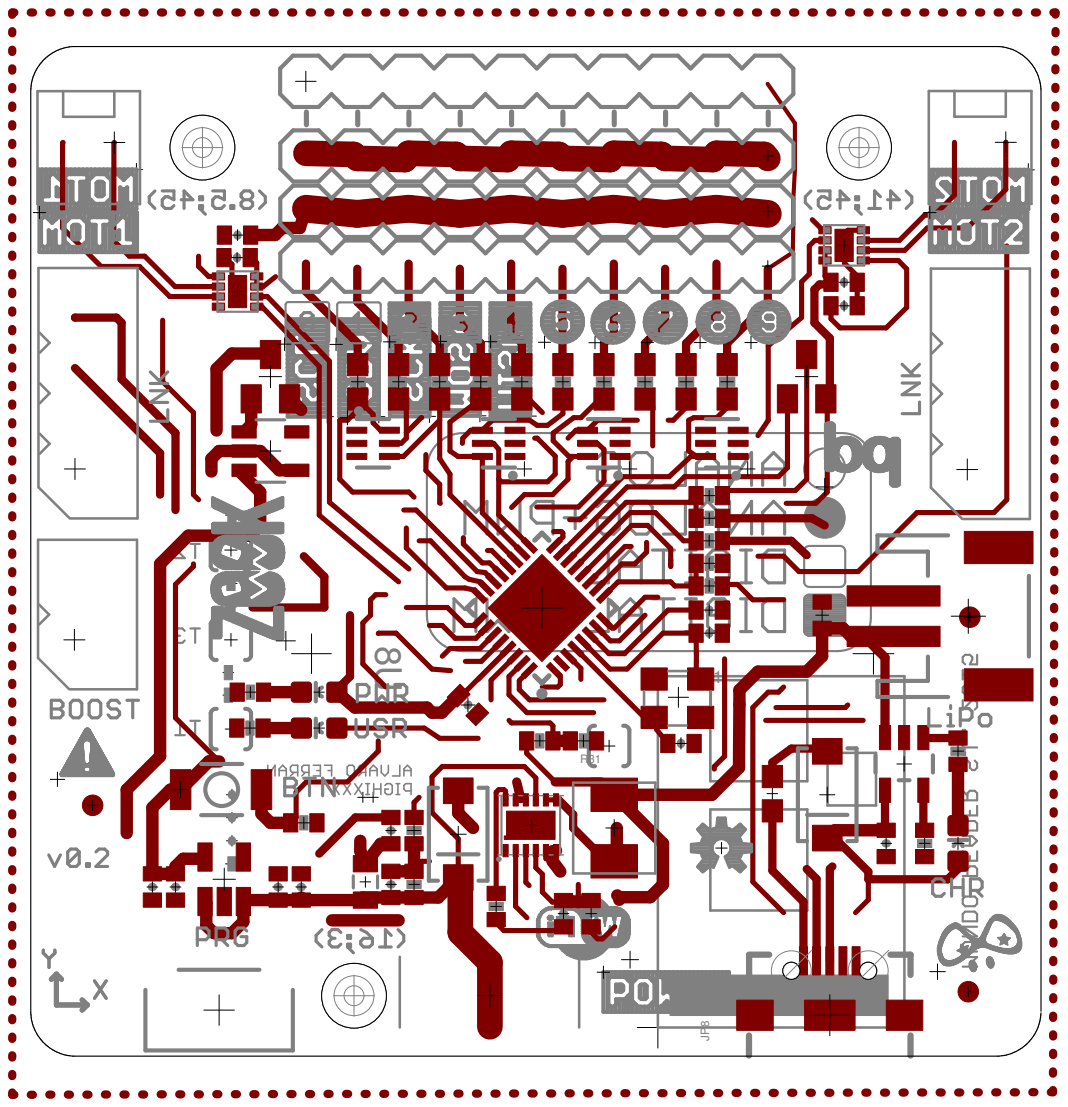
[picture p22: page 1]
