alvaroferran/ZOOK/zook.brd

## EAGLE design zook.brd (2015-11-03)

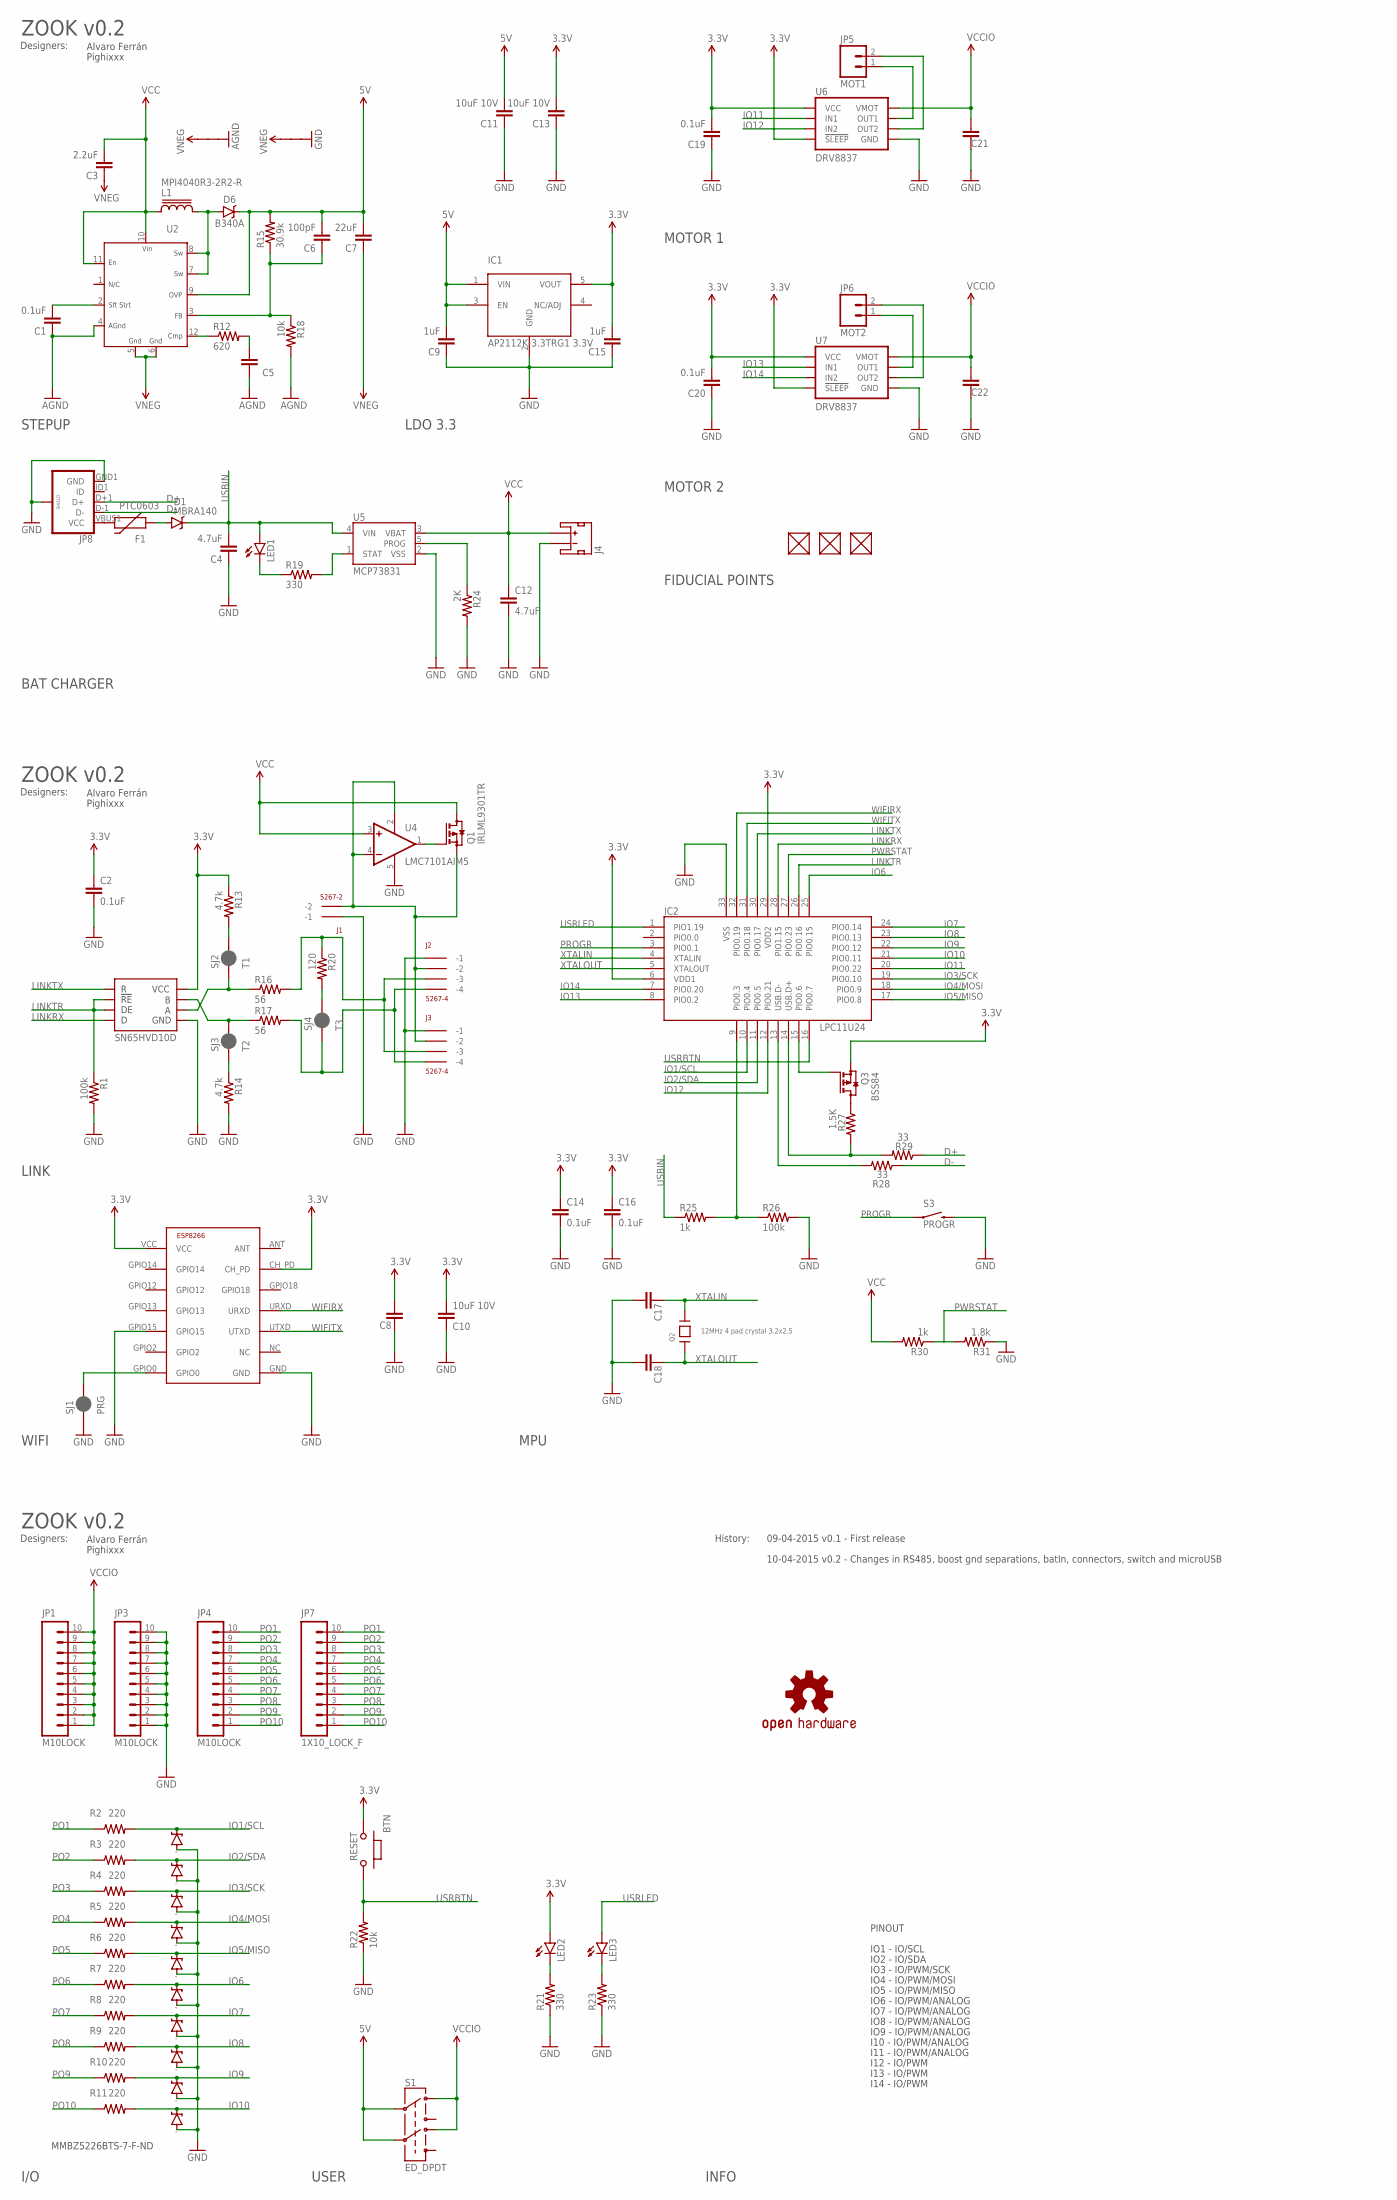
[picture p23: schematic zook.sch]

Parts:
BTN: RESET; 157SW
C1, C2, C8, C14, C16, C19, C20, C21, C22: 0.1uF; 0402-CAP
C3: 2.2uF; 0402-CAP
C4, C12: 4.7uF; 0402-CAP
C5: 10nF; 0402-CAP
C6: 100pF; 0402-CAP
C7: 22uF; 0805
C9, C15: 1uF; 0402-CAP
C10, C11, C13: 10uF 10V; 0402-CAP
C17, C18: 27pF; 0402-CAP
D1: MBRA140; SMA-DIODE
D2, D3, D4, D5: ZENERARRAY; SOT363
D6: B340A; SMA-DIODE
F1: PTC0603; 0603
FUD1, FUD2, FUD3: FIDUCIAL; FIDUCIAL_40MIL
GND5, GND6: VIRTUAL_GND; STARGND
IC1: AP2112K-3.3TRG1 3.3V; SOT23-5
IC2: LPC11U24; HVQFN33_5X5MM
J1: 5267-2
J2, J3: 5267-4
J4: BATT; JST-2-SMD
JP1, JP3, JP4: M10LOCK; 1X10_LOCK
JP5: MOT1; MOLEX-1X2
JP6: MOT2; MOLEX-1X2
JP7: 1X10_LOCK_F
JP8: USB_MICROB_PLUGCONN-11752; USB-B-MICRO-SMD_V03
L1: MPI4040R3-2R2-R
LED1, LED2, LED3: LED0603; LED-0603
LOGO3: OSHW-LOGOS; OSHW-LOGO-S
Q1: IRLML9301TR; SOT23
Q2: 12MHz 4 pad crystal 3.2x2.5; CRYSTAL_3.2X2.5
Q3: BSS84; SOT23
R1, R26: 100k; 0402-RES
R2, R3, R4, R5, R6, R7, R8, R9, R10, R11: 220; 0603-RES
R12: 620; 0402-RES
R13, R14: 4.7k; 0402-RES
R15: 30.9k; 0402-RES
R16, R17: 56; 0402-RES
R18, R22: 10k; 0402-RES
R19, R21, R23: 330; 0402-RES
R20: 120; 0402-RES
R24: 2K; 0402-RES
R25, R30: 1k; 0402-RES
R27: 1.5K; 0402-RES
R28, R29: 33; 0402-RES
R31: 1.8k; 0402-RES
S1: ED_DPDT
S3: PROGR; TACTILE-PTH-SIDEEZ
SJ1: PRG; PAD-JUMPER-2-NC_BY_PASTE_YES_SILK
SJ2: T1; PAD-JUMPER-2-NC_BY_PASTE_YES_SILK
SJ3: T2; PAD-JUMPER-2-NC_BY_PASTE_YES_SILK
SJ4: T3; PAD-JUMPER-2-NC_BY_PASTE_YES_SILK
U2: MIC2253; MLF12_3.0MM_X_3.0MM
U3: ESP8266; ESP-03
U4: LMC7101AIM5; SOT23-5
U5: MCP73831; SOT23-5
U6, U7: DRV8837; DSG
U8: SN65HVD10D; SO08

Connections:
3.3V: BTN.1, C2.1, C8.2, C10.2, C13.2, C14.1, C15.2, C16.1, C19.2, C20.2, IC1.5 (VOUT), IC2.6 (VDD1), IC2.29 (VDD2), LED2.A, Q3.2 (S), R13.1, U3.CH_PD, U3.VCC, U6.7 (!SLEEP), U6.8 (VCC), U7.7 (!SLEEP), U7.8 (VCC), U8.8
5V: C6.2, C7.2, C9.2, C11.2, D6.C, IC1.1 (VIN), IC1.3 (EN), R15.2, S1.2, S1.5, U2.9 (OVP)
AGND: C1.1, C5.1, GND5.P$2, R18.2, U2.4 (AGND)
D+: JP8.D+1 (D+), R29.1
D-: JP8.D-1 (D-), R28.1
GND: C2.2, C4.1, C8.1, C9.1, C10.1, C11.1, C12.2, C13.1, C14.2, C15.1, C16.2, C17.2, C18.2, C19.1, C20.1, C21.1, C22.1, D2.1 (A), D2.2 (A), D2.3 (A), D3.1 (A), D3.2 (A), D3.3 (A), D4.1 (A), D4.2 (A), D4.3 (A), D5.1 (A), GND6.P$2, IC1.2 (GND), IC2.33 (VSS), J1.P$1 (-1), J2.P$1 (-1), J3.P$1 (-1), J4.1 (-), JP3.1, JP3.2, JP3.3, JP3.4, JP3.5, JP3.6, JP3.7, JP3.8, JP3.9, JP3.10, JP8.GND1 (GND), JP8.SHIELD1 (SHIELD), JP8.SHIELD2 (SHIELD), JP8.SHIELD3 (SHIELD), R1.2, R14.2, R21.1, R22.1, R23.1, R24.2, R26.2, R31.1, S3.2, SJ1.1, U3.GND, U3.GPIO15, U4.5 (V-), U5.2 (VSS), U6.4 (GND), U6.PAD (GND), U7.4 (GND), U7.PAD (GND), U8.5
IO1/SCL: D2.6 (C), IC2.10 (PIO0.4), R2.2
IO2/SDA: D2.5 (C), IC2.11 (PIO0.5), R3.2
IO3/SCK: D2.4 (C), IC2.19 (PIO0.10), R4.2
IO4/MOSI: D3.6 (C), IC2.18 (PIO0.9), R5.2
IO5/MISO: D3.5 (C), IC2.17 (PIO0.8), R6.2
IO6: D3.4 (C), IC2.25 (PIO0.15), R7.2
IO7: D4.6 (C), IC2.24 (PIO0.14), R8.2
IO8: D4.5 (C), IC2.23 (PIO0.13), R9.2
IO9: D4.4 (C), IC2.22 (PIO0.12), R10.2
IO10: D5.6 (C), IC2.21 (PIO0.11), R11.2
IO11: IC2.20 (PIO0.22), U6.6 (IN1)
IO12: IC2.12 (PIO0.21), U6.5 (IN2)
IO13: IC2.8 (PIO0.2), U7.6 (IN1)
IO14: IC2.7 (PIO0.20), U7.5 (IN2)
LINKRX: IC2.28 (PIO1.15), U8.4
LINKTR: IC2.26 (PIO0.16), R1.1, U8.2, U8.3
LINKTX: IC2.30 (PIO0.17), U8.1
unnamed: J2.P$4 (-4), J3.P$4 (-4), R17.2, SJ4.1
unnamed: LED2.C, R21.2
unnamed: C5.2, R12.2
unnamed: D6.A, L1.P$2 (2), U2.7 (SW), U2.8 (SW)
unnamed: C1.2, U2.2 (SS)
unnamed: F1.2, JP8.VBUS1 (VCC)
unnamed: R12.1, U2.12 (CMP)
unnamed: D1.A, F1.1
unnamed: JP5.1, U6.2 (OUT1)
unnamed: JP5.2, U6.3 (OUT2)
unnamed: R19.2, U5.1 (STAT)
unnamed: LED1.C, R19.1
unnamed: JP6.1, U7.2 (OUT1)
unnamed: JP6.2, U7.3 (OUT2)
unnamed: R17.1, SJ3.2, U8.7
unnamed: R16.1, SJ2.1, U8.6
unnamed: R13.2, SJ2.2
unnamed: R20.2, SJ4.2
unnamed: R14.1, SJ3.1
unnamed: J2.P$3 (-3), J3.P$3 (-3), R16.2, R20.1
unnamed: LED3.C, R23.2
unnamed: C6.1, R15.1, R18.1, U2.3 (FB)
unnamed: Q1.1 (G), U4.1 (OUT)
unnamed: J1.P$2 (-2), J2.P$2 (-2), J3.P$2 (-2), Q1.2 (S), U4.2 (V+), U4.4 (-IN)
unnamed: IC2.14 (USB.D+), R27.2, R29.2
unnamed: SJ1.2, U3.GPIO0
unnamed: IC2.13 (USB.D-), R28.2
unnamed: Q3.3 (D), R27.1
unnamed: IC2.15 (PIO0.6), Q3.1 (G)
P0.3/ISP_COMMAND_USB_HIGH: IC2.9 (PIO0.3), R25.2, R26.1
PO1: JP4.10, JP7.10, R2.1
PO2: JP4.9, JP7.9, R3.1
PO3: JP4.8, JP7.8, R4.1
PO4: JP4.7, JP7.7, R5.1
PO5: JP4.6, JP7.6, R6.1
PO6: JP4.5, JP7.5, R7.1
PO7: JP4.4, JP7.4, R8.1
PO8: JP4.3, JP7.3, R9.1
PO9: JP4.2, JP7.2, R10.1
PO10: JP4.1, JP7.1, R11.1
PROG: R24.1, U5.5 (PROG)
PROGR: IC2.3 (PIO0.1), S3.1
PWRSTAT: IC2.27 (PIO0.23), R30.1, R31.2
USBIN: C4.2, D1.C, LED1.A, R25.1, U5.4 (VIN)
USRBTN: BTN.2, IC2.16 (PIO0.7), R22.2
USRLED: IC2.1 (PIO1.19), LED3.A
VCC: C3.2, C12.1, J4.2 (+), L1.P$1 (1), Q1.3 (D), R30.2, U2.10 (VIN), U2.11 (EN), U4.3 (+IN), U5.3 (VBAT)
VCCIO: C21.2, C22.2, JP1.1, JP1.2, JP1.3, JP1.4, JP1.5, JP1.6, JP1.7, JP1.8, JP1.9, JP1.10, S1.1, S1.4, U6.1 (VMOT), U7.1 (VMOT)
VNEG: C3.1, C7.1, GND5.P$1, GND6.P$1, U2.5 (GND), U2.6 (GND)
WIFIRX: IC2.32 (PIO0.19), U3.URXD
WIFITX: IC2.31 (PIO0.18), U3.UTXD
XTALIN: C17.1, IC2.4 (XTALIN), Q2.3
XTALOUT: C18.1, IC2.5 (XTALOUT), Q2.1

Notes on the sheet:
STEPUP
LDO 3.3
BAT CHARGER
MOTOR 1
MOTOR 2
FIDUCIAL POINTS
ZOOK v0.2
Designers:
Alvaro Ferrán
Pighixxx
LINK
WIFI
MPU
I/O
USER
INFO
History:
09-04-2015 v0.1 - First release
IO1 - IO/SCL
IO2 - IO/SDA
IO3 - IO/PWM/SCK
IO4 - IO/PWM/MOSI
IO5 - IO/PWM/MISO
IO6 - IO/PWM/ANALOG
IO7 - IO/PWM/ANALOG
IO8 - IO/PWM/ANALOG
IO9 - IO/PWM/ANALOG
I10 - IO/PWM/ANALOG
PINOUT
MMBZ5226BTS-7-F-ND
10-04-2015 v0.2 - Changes in RS485, boost gnd separations, batIn, connectors, switch and microUSB
I11 - IO/PWM/ANALOG
I12 - IO/PWM
I13 - IO/PWM
I14 - IO/PWM

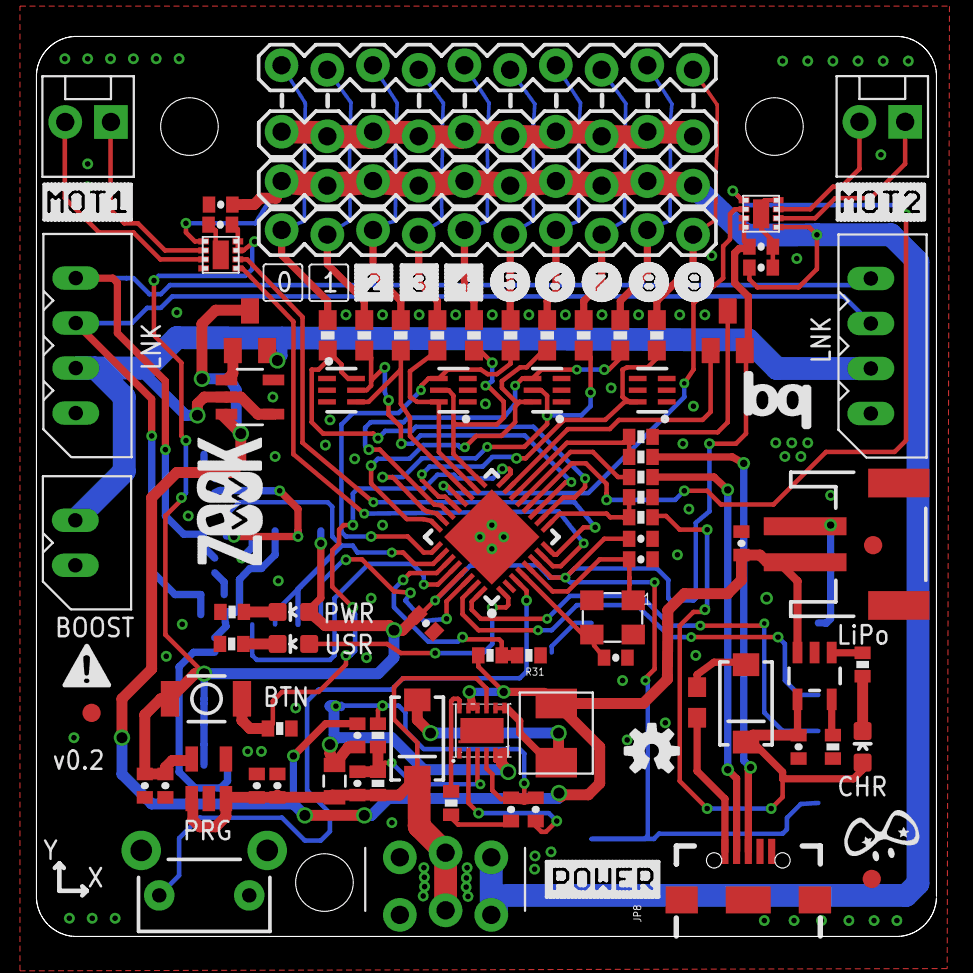
[picture p24: board zook.brd from above]

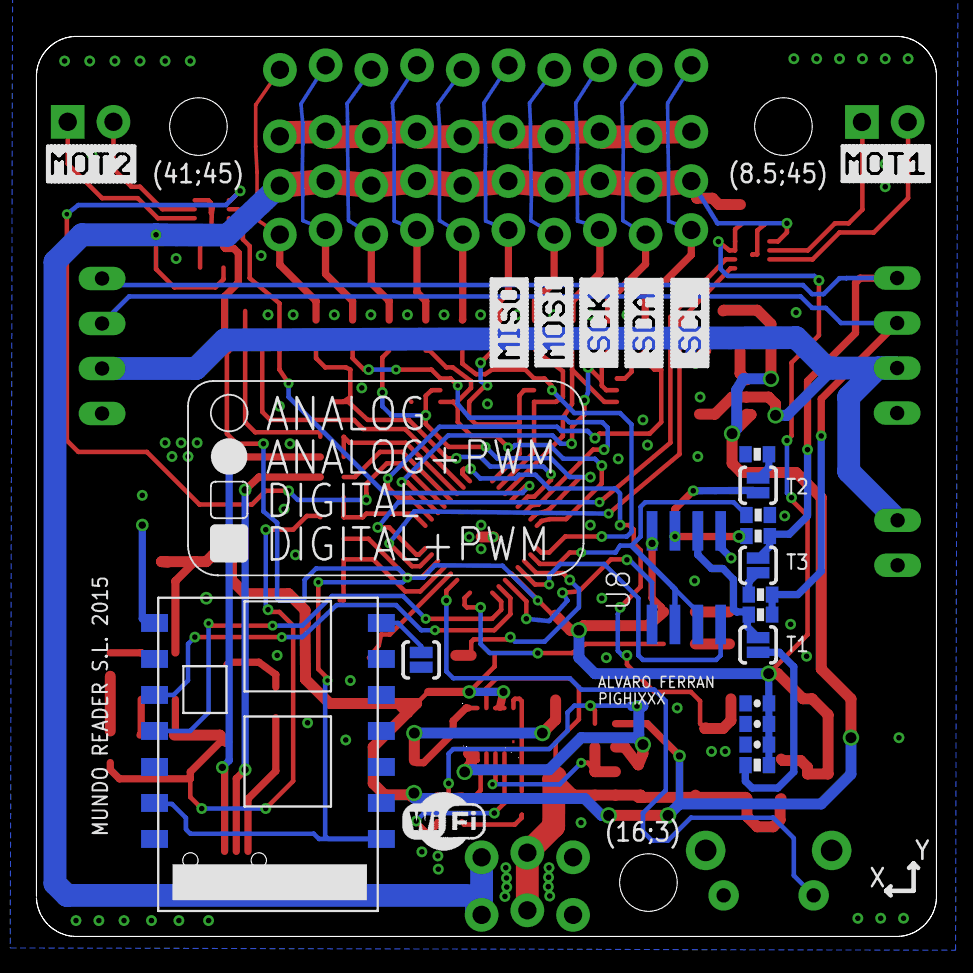
[picture p25: board zook.brd from below]

Board: 2 copper layers, 50.0 x 50.0 mm, 126 parts (26 on the bottom side), 76 nets.

Other parts of the board:
U$1: S_1_P
U$2: S_2
U$3: S_0_P
U$4: S_5_R
U$5: S_3
U$6: S_4
U$7: S_6_R
U$8: S_7_R
U$9: S_8_R
U$10: S_9_R
U$11: S_SCL
U$12: S_SDA
U$13: S_MOSI
U$14: S_MISO
U$15: S_SCK
U$16, U$25: S_MOT1
U$17, U$26: S_MOT2
U$18: S_LEGEND
U$19: S_POWER
U$20: S_WIFI
U$21: S_ZOOK_LOGO
U$22: S_ATTENTION
U$23: PIGHIXXX_LOGO
U$27: BQ_LOGO_MEDIUM
