alvaroferran/ZOOK/(notices)

Notices in the files:
parts and their libraries:
SparkFun-Aesthetics: Licensing: Creative Commons ShareAlike 4.0 International - https://creativecommons.org/licenses/by-sa/4.0
SparkFun-DiscreteSemi: Licensing: CC v3.0 Share-Alike You are welcome to use this library for commercial purposes.
